hamdan0777/JAZ-Competition-2026/docs/hev_poster.docx

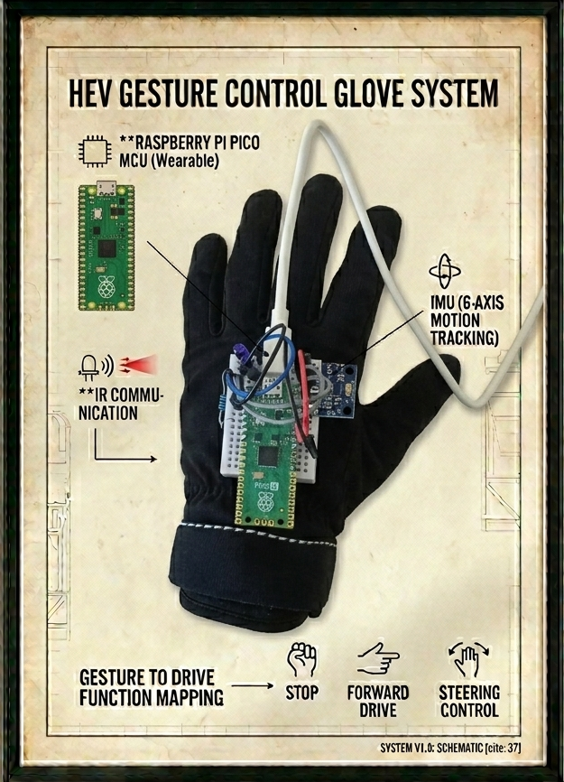
[picture p1: figure]
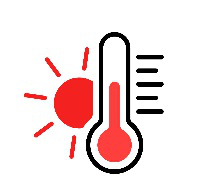
[picture p2: figure]
Thermometer icon heat temperature scale symbol – Royalty-Free Vector | VectorStock
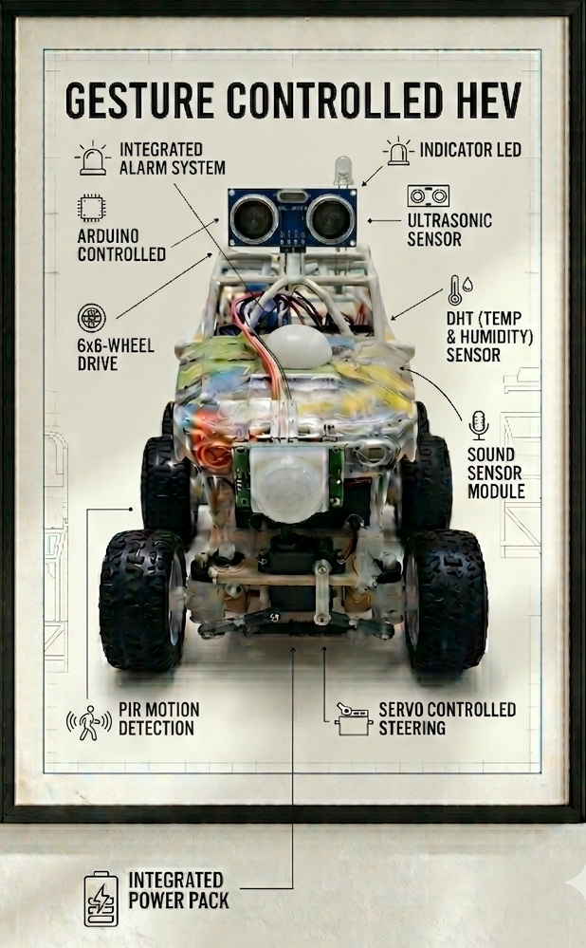
[picture p3: figure]
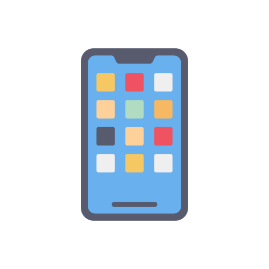
[picture p4: figure]
Mobile app - Free technology icons
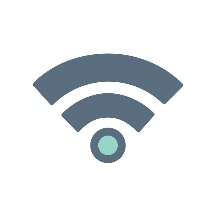
[picture p5: figure]
Wifi logo Vectors - Download Free High-Quality Vectors | Magnific (formerly Freepik)
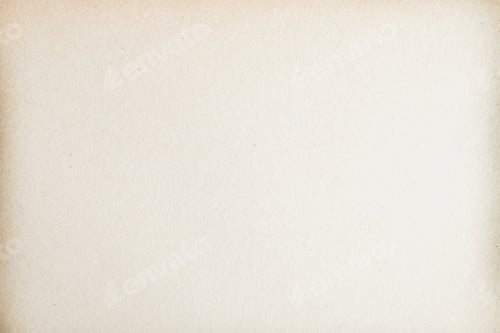
[picture p6: figure]
Paper Background Royalty-Free Stock Photos - Envato

INTEGRATED WEB APP

- Dashboard
- Clean Data Visuals
- Control from App

HEAT INDEX, DEW POINT & HAZARD SCORES

WIFI CONNECTIVITY & THINGSPEAK IoT CAPABILITIESVITY
