hamdan0777/JAZ-Competition-2026/docs/BILL OF MATERIALS.docx

BILL OF MATERIALS – JAZ COMPETITION 26

# | Component | Subsystem | Qty | Role | Specs | COST ESTIMATE

Microcontrollers
1 | Arduino Uno R3 | Vehicle | 1 | Main MCU | ATmega328P, 5V, 16MHz | 35
2 | Raspberry Pi Pico 2 | Glove | 1 | Glove controller | RP2350, 3.3V, 150MHz | 25
Sensors
3 | MPU-6050 | Glove | 1 | Gesture sensing | 6-axis IMU, I2C, 3.3V | 10
4 | DHT11 | Vehicle | 1 | Temp + humidity | ±2°C, ±5% RH, digital | 7
5 | HC-SR04 | Vehicle | 1 | Obstacle detection | 2cm–400cm, 5V | 7
6 | HC-SR501 PIR | Vehicle | 1 | Motion detection | 3–7m range, 5V | 7
7 | Sound sensor module | Vehicle | 1 | Acoustic detection | Analog + digital out, 5V | 7
Actuators
8 | RC axle DC motor | Vehicle | 1 | Drive (fwd/back) | 3–6V DC | 20
9 | SG90 Servo motor | Vehicle | 1 | Front steering | 4.8–6V, 1.8kg.cm, 180° | 12
10 | Active buzzer | Vehicle | 1 | Hazard alert | 5V, 85dB | 2
Communication
11 | IR LED (extracted) | Glove | 1 | IR transmission | 940nm, 5V, NEC protocol | 2
12 | HX1838 IR receiver | Vehicle | 1 | Receives commands | 38kHz, 5V, 18m range | 4
13 | IR remote control | Vehicle | 1 | Backup controller | NEC protocol, 21 buttons | 5
Motor Driver
14 | L293D | Vehicle | 1 | Motor driver IC | 600mA/ch, 4.5–36V | 5
Indicators
15 | RGB LED | Vehicle | 1 | Hazard indicator | Common cathode, 5V | 2
16 | LED (red/green) | Vehicle | 1 | Status/headlight | 5mm, 5V + resistor | 1
Power
17 | 9V battery | Vehicle | 1 | Motor supply | 9V, L293D Vmotor | 5
18 | 9V battery | Glove | 1 | Glove power | 9V → PSU → 5V → Pico 2 | 5
19 | Breadboard PSU module | Glove | 1 | Voltage regulation | 9V in → 5V out | 10
20 | 9V DC connector | Vehicle | 1 | Battery connector | Barrel jack | 3
Passive Components
21 | Resistors | Both | ~10 | Current limiting | 100Ω, 220Ω, 330Ω, 1kΩ | 4
22 | Capacitors (electrolytic) | Vehicle | 2 | Motor noise filter | 100µF, 16V | 2
23 | Capacitors (ceramic) | Vehicle | 2 | Motor noise filter | 100nF | 2
Mechanical
24 | RC car axle + wheels | Vehicle | 1 | Chassis + drive | Repurposed RC car | 40
25 | Perfboard 5×7cm | Vehicle | 1 | Final assembly | 5cm × 7cm | 4
26 | Breadboard 830pt | Both | 2 | Prototyping | 830 tie-point | 10
27 | Jumper wires | Both | ~40 | Connections | Male-male, male-female | 10
Connection
28 | USB-B cable | Bridge | 1 | Arduino to laptop | USB 2.0 | 5
29 | USB-A extension cable | Bridge | 1 | Operating radius | 3–5m | 20
Software
30 | Python (venv) | Bridge | — | Serial bridge | pyserial, requests, dotenv | -
31 | ThingSpeak account | Bridge | — | IoT dashboard | 8 fields, MATLAB viz | -
32 | MicroPython | Glove | — | Pico 2 firmware | ir_tx, machine, I2C | -
| TOTAL | | | | | 271 AED
