hamdan0777/JAZ-Competition-2026/(commit log)

2026-09-06 Add IMU data reading and IR LED control logic
    Implement IMU data reading and IR LED control based on accelerometer values.
2026-09-06 Add ThingSpeak logger for Arduino data
    Implement a logger to read data from Arduino and send it to ThingSpeak, including command handling.
